CloudEngineHub/robot-utility-models/hardware/stretch3Mount/NOTE.md

This [gopro_mount.stl](gopro_mount.stl) is a mount for the GoPro. Which is a pair with the [stick_v3_body_and_gopro_mount.stl](../stickV2/AssemblyInstruction/stick_v3_body_and_gopro_mount.stl).

Need to use a soldering iron to mount the Brass Tapered Heat-Set Inserts into the 3D printed parts.
