CloudEngineHub/robot-utility-models/hardware/stickV2/AssemblyInstruction/stick_v3_body_and_phone_mount.stl

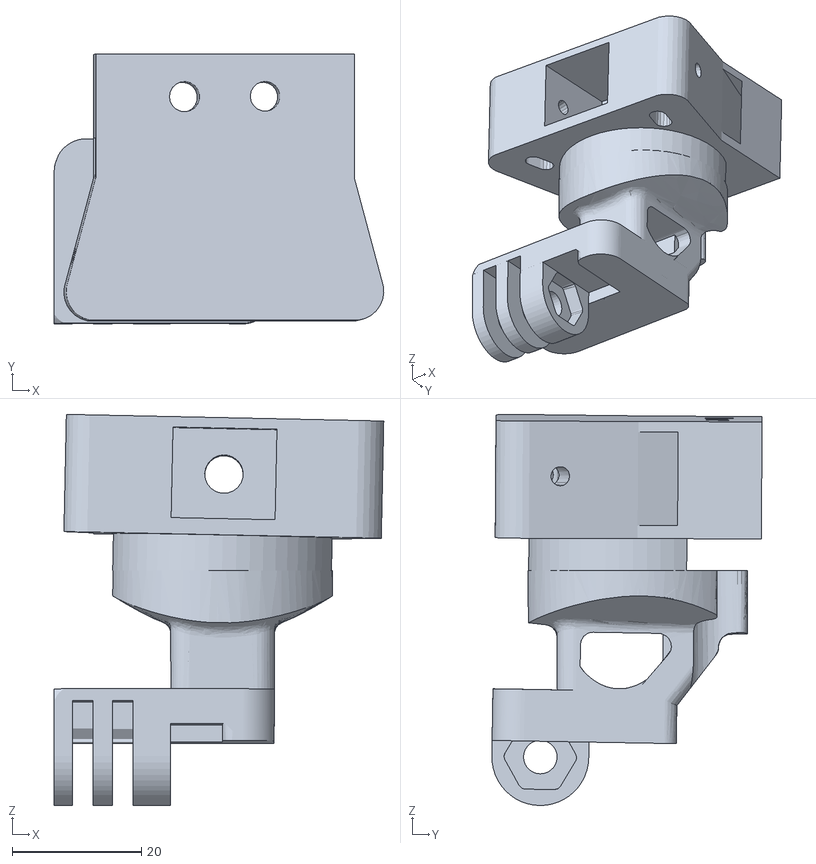
[picture p1: CAD file, 2026-01-06]
hardware/stickV2/AssemblyInstruction/stick_v3_body_and_phone_mount.stl
51.0 x 41.8 x 60.5
