CloudEngineHub/robot-utility-models/hardware/stretch3Mount/gopro_mount.stl

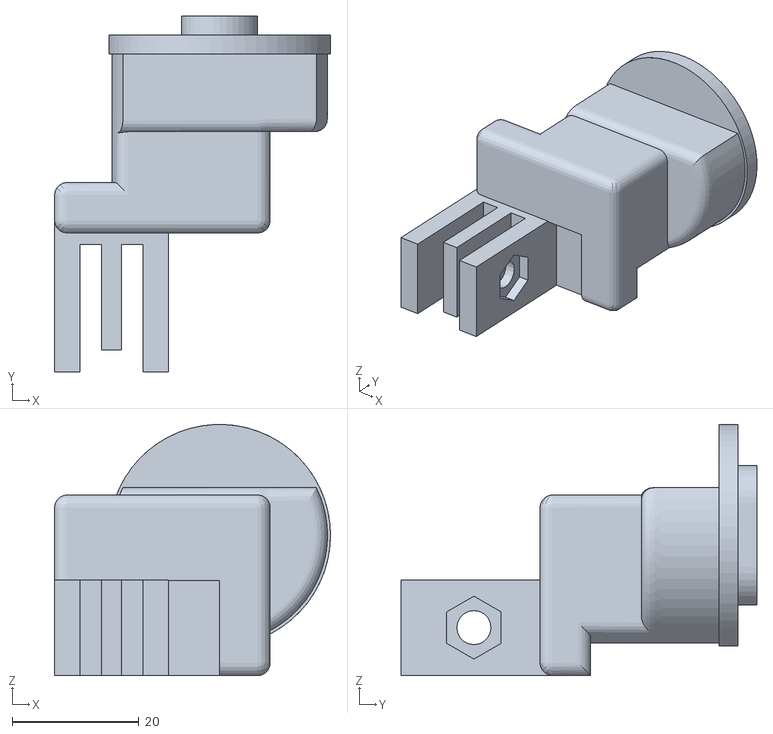
[picture p2: CAD file, 2026-01-06]
hardware/stretch3Mount/gopro_mount.stl
43.6 x 56.2 x 39.6
