CloudEngineHub/robot-utility-models/hardware/stickV2/AssemblyInstruction/stick_v3_body_and_gopro_mount.stl

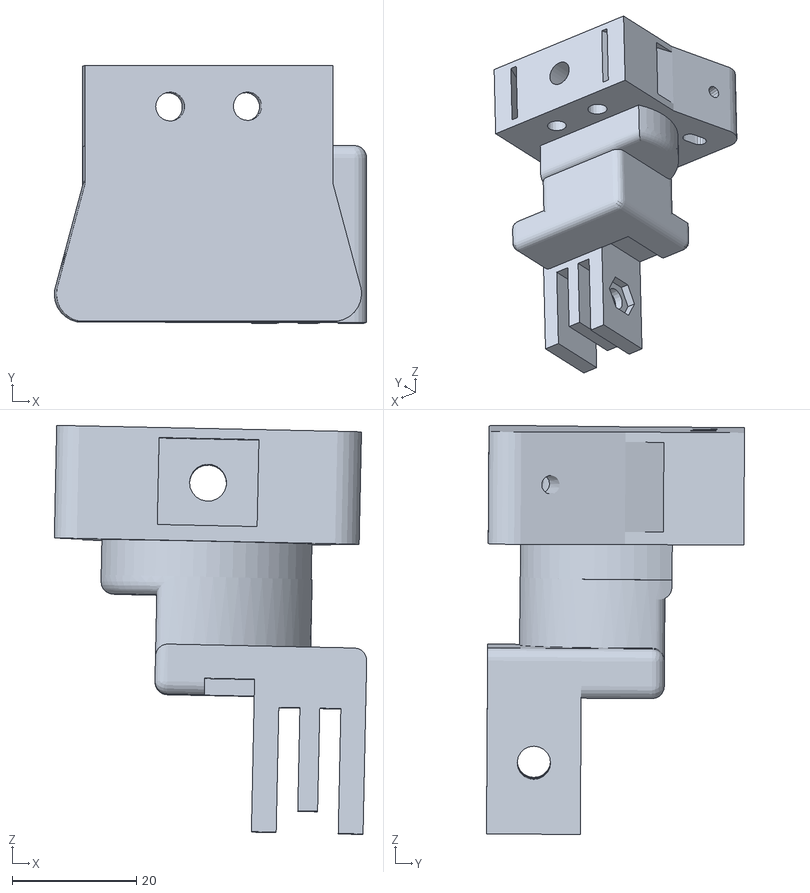
[picture p3: CAD file, 2026-01-06]
hardware/stickV2/AssemblyInstruction/stick_v3_body_and_gopro_mount.stl
50.3 x 41.6 x 65.9
