CloudEngineHub/robot-utility-models/hardware/stickV2/AssemblyInstruction/assets/final.png

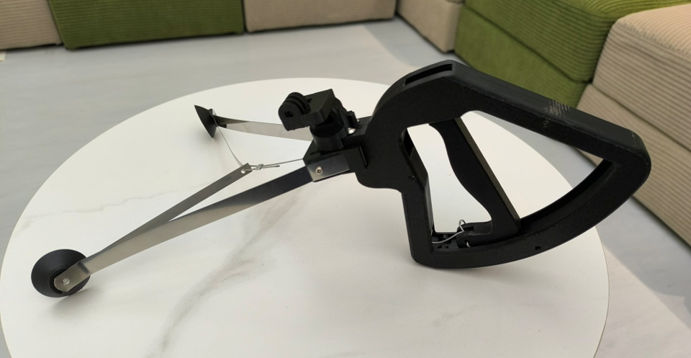
[picture p11: hardware/stickV2/AssemblyInstruction/assets/final.png]
