CloudEngineHub/robot-utility-models/hardware/stickV2/AssemblyInstruction/Instruction.md

1. Use a 3D printer to print all parts

* [left_handle](../stickBody/left_handle.stl)
* [right_handle](../stickBody/right_handle.stl)
* [dobbe_trigger](../stickBody/dobbe_trigger.STL)
* [stick_v3_body_and_phone_mount](stick_v3_body_and_phone_mount.stl)

2. Disassemble the trash gripper and keep only the gripping jaws
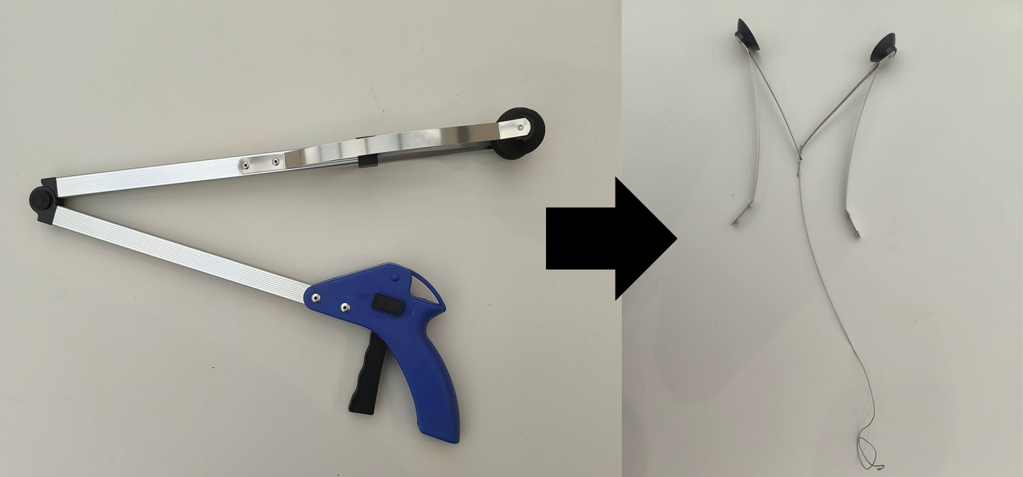
[picture p4: hardware/stickV2/AssemblyInstruction/assets/disassemble_gripper.png]

Before proceeding to the next step, it is recommended to put Heat Shrink Tubing over the jaws to prevent cutting your hands.

3. Attach the jaws to the stick_v3_body_and_phone_mount
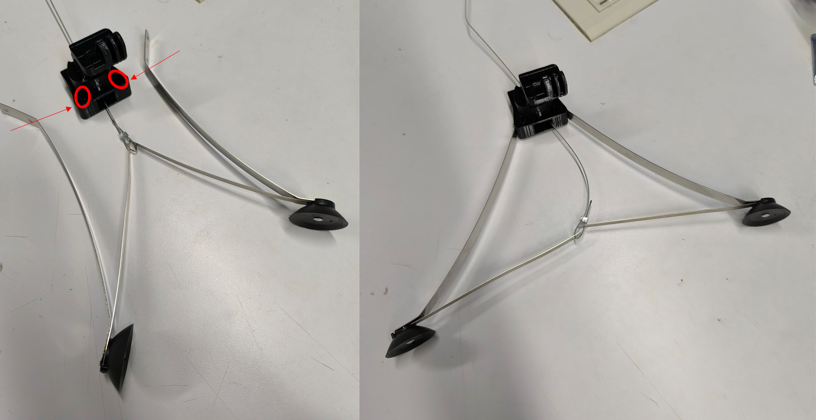
[picture p5: hardware/stickV2/AssemblyInstruction/assets/assemble_gripper_and_body.png]

Place the nut into the red circled area, then tighten the screw following the direction of the arrow.

4. Insert the Dowel Pin into the hole of the left_handle (it will require some force), then remove the Dowel Pin and insert it into the hole of the right_handle (this helps align both holes to make fixing the Dowel Pin easier in the next steps).
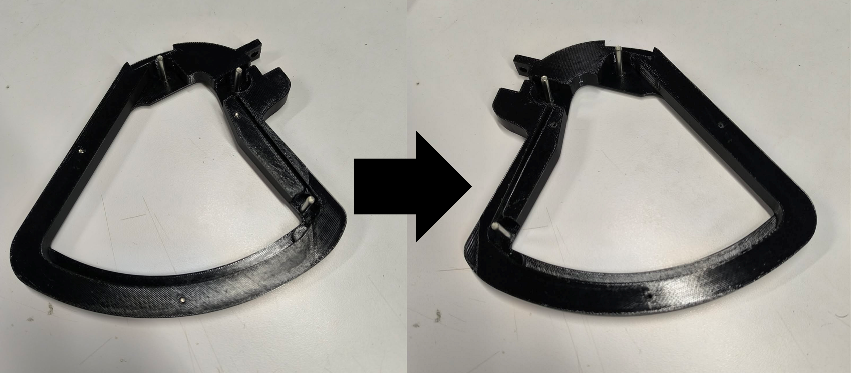
[picture p6: hardware/stickV2/AssemblyInstruction/assets/dowel_pin_insert.png]


5. Secure the gripper cable to the dobbe_trigger, cut off any excess cable, and temporarily secure the gripper with a rubber band.
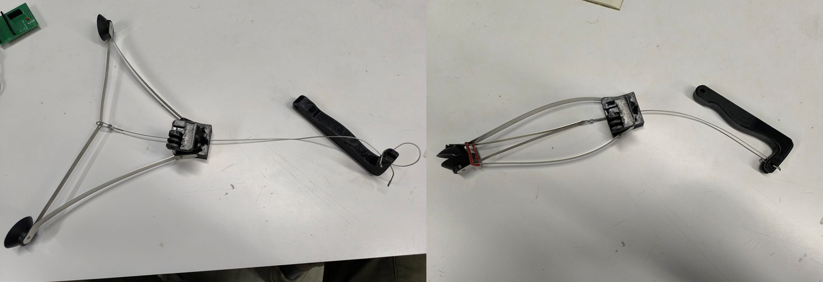
[picture p7: hardware/stickV2/AssemblyInstruction/assets/assemble_gripper_and_trigger.png]


6. Attach the dobbe_trigger to the right_handle, and secure the cable into the groove on the right_handle, routing it around the Dowel Pin.
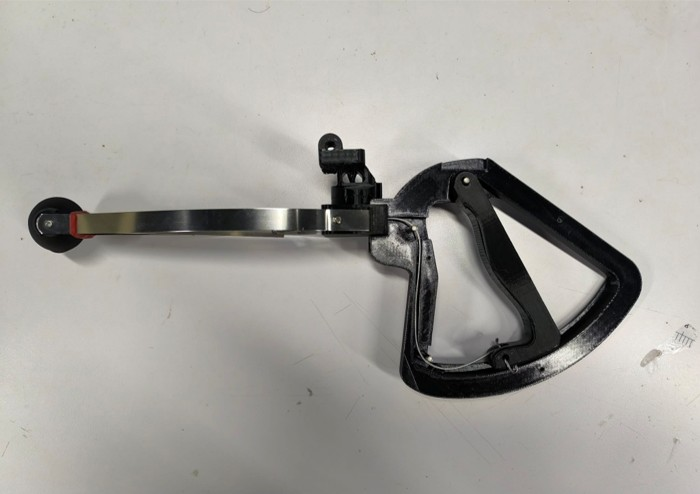
[picture p8: hardware/stickV2/AssemblyInstruction/assets/assemble_trigger_and_right_handle.png]


7. Place the left_handle cover on and fasten it with Thread-Forming Screws.
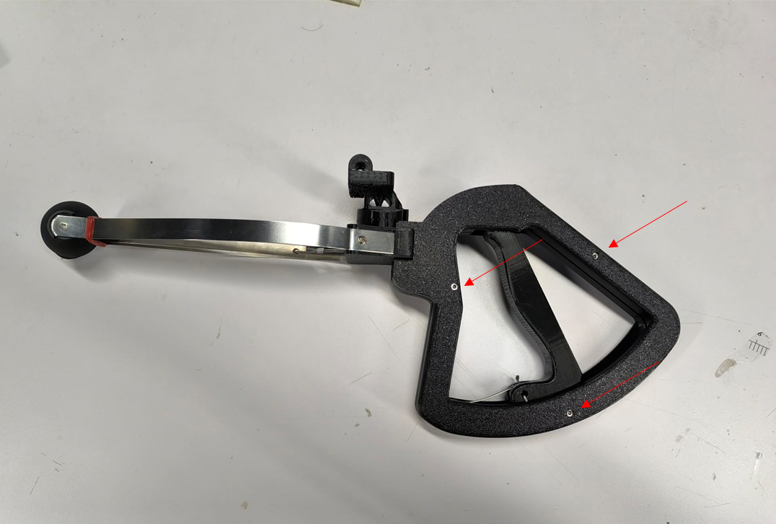
[picture p9: hardware/stickV2/AssemblyInstruction/assets/assemble_left_handle.png]


8. Fasten the stick_v3_body_and_phone_mount to the right_handle and left_handle with screws, then remove the rubber band.
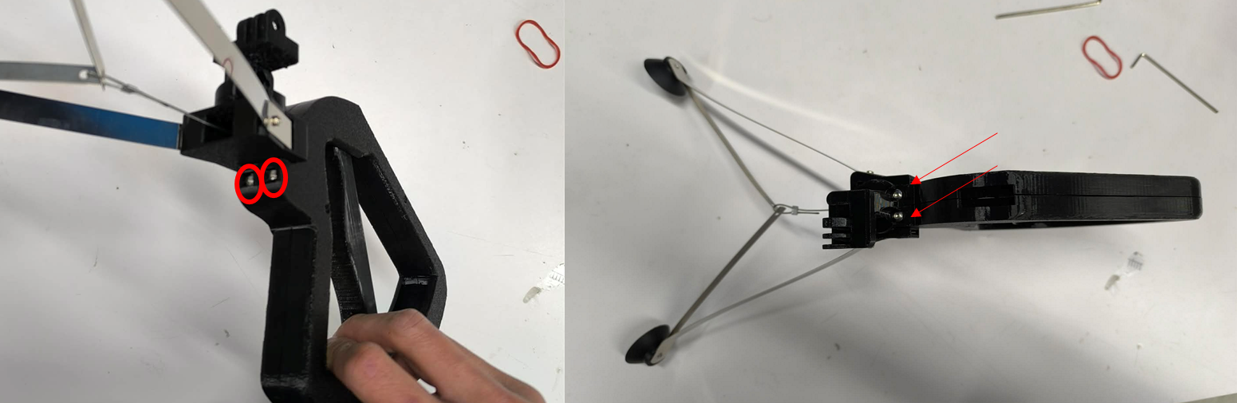
[picture p10: hardware/stickV2/AssemblyInstruction/assets/assemble_body_and_handles.png]


9. Finished
